valveteam/documentation/README.md

# documentation
Contains documentation files for valve team (GM2)
