valveteam/documentation/enclosure files/light_enclosure.stl

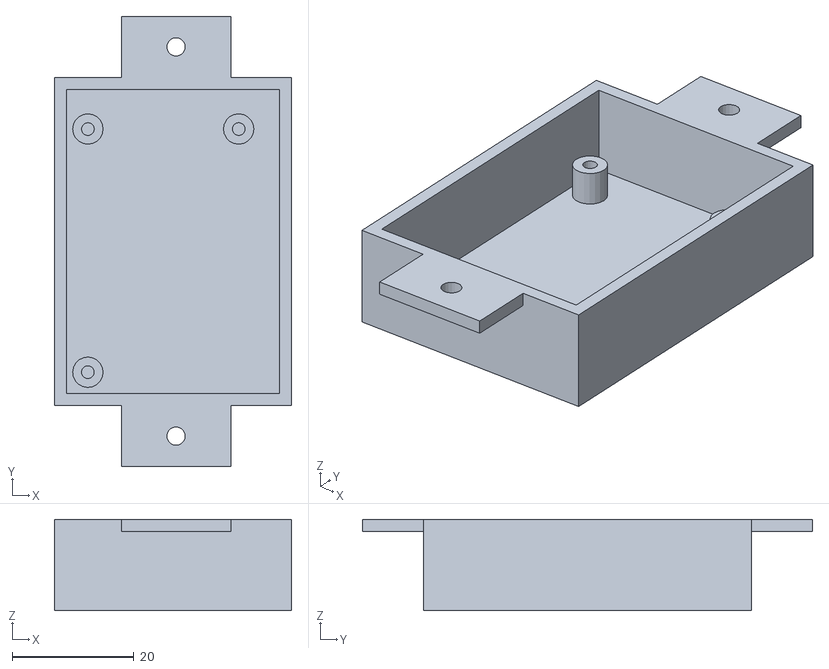
[picture p21: CAD file, 2018-06-06]
enclosure files/light_enclosure.stl
39.0 x 74.0 x 15.0
