valveteam/documentation/enclosure files/control_flow_enclosure.stl

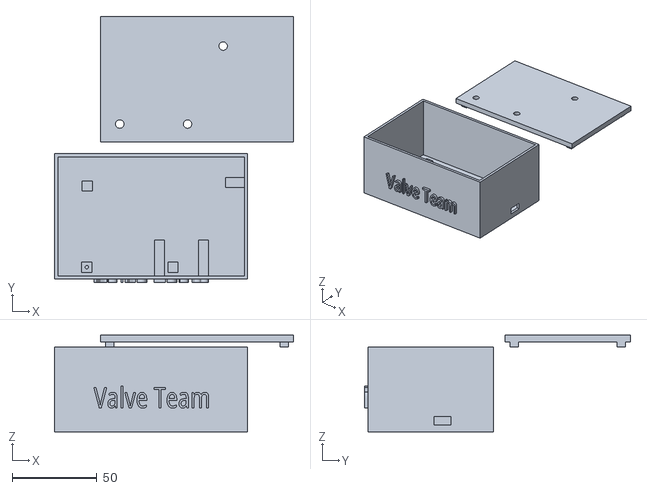
[picture p22: CAD file, 2018-06-06]
enclosure files/control_flow_enclosure.stl
141.0 x 157.0 x 57.0
