valveteam/documentation/submodules/light_module_res/light_module_schematic.pdf

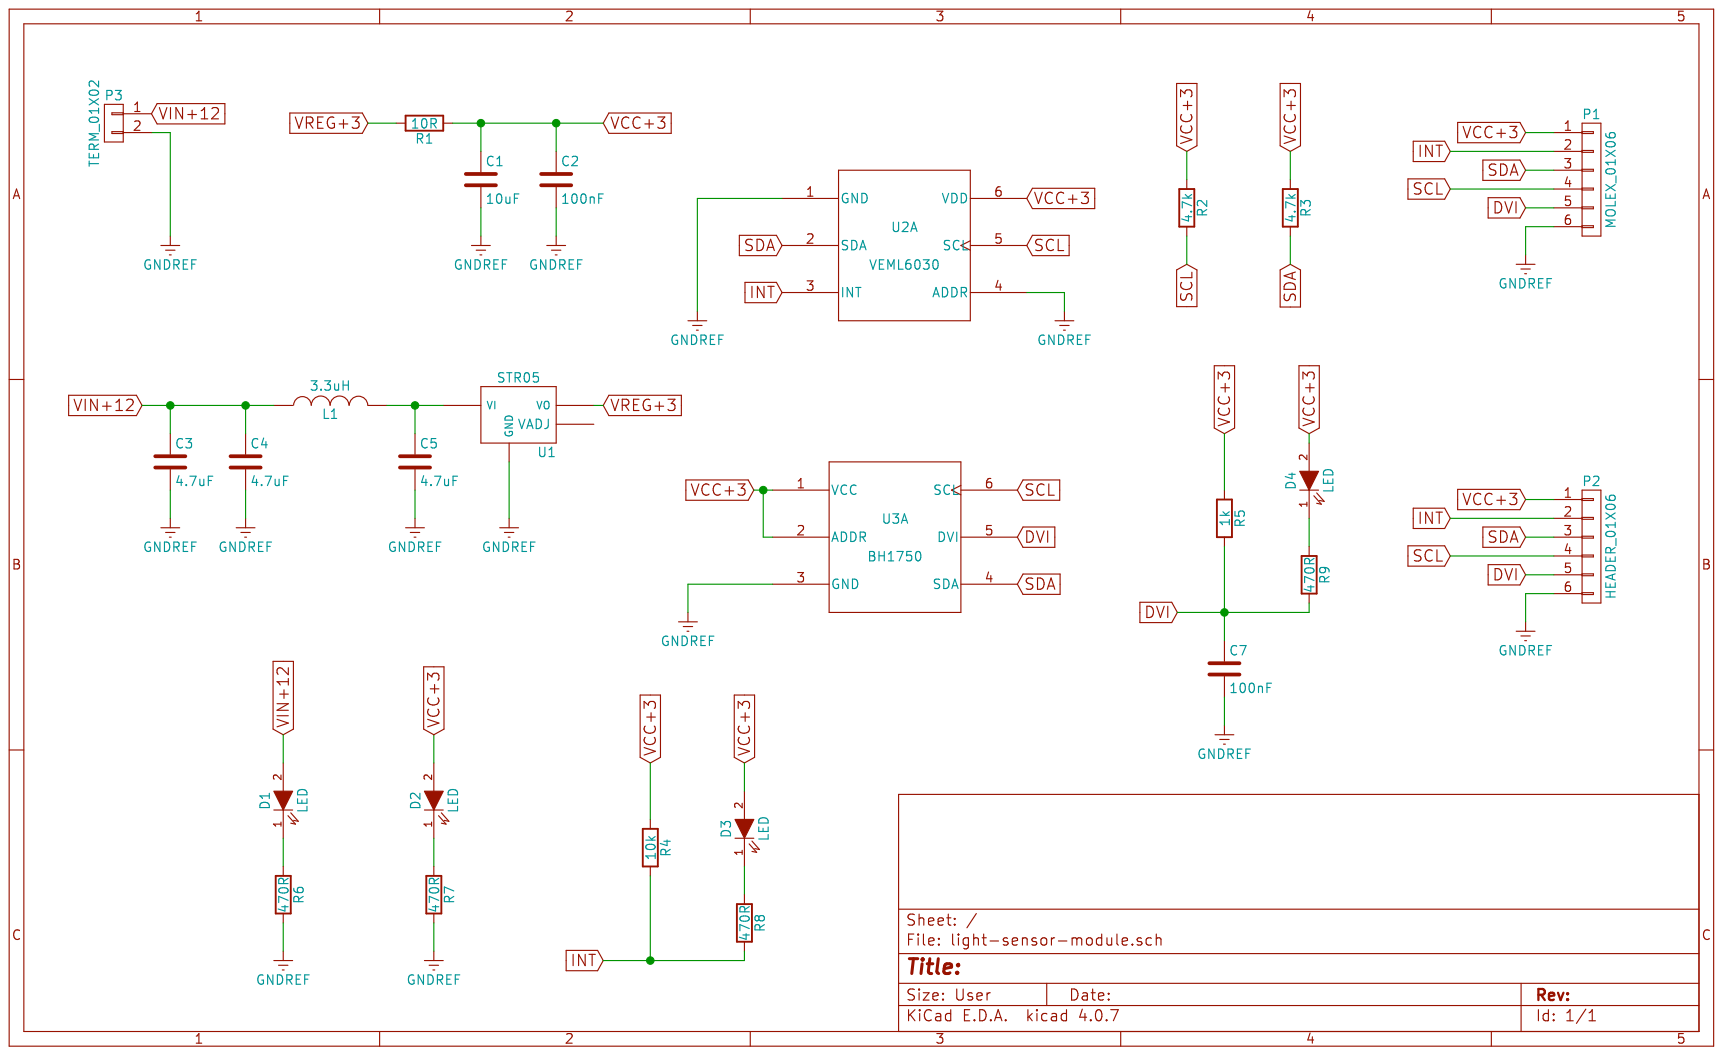
[picture p23: page 1]
