valveteam/documentation/(commit log)

2018-05-31 initial flow_control_module work.
2018-06-04 Add information about valves.
2018-06-05 Add resources for light sensor module
2018-06-05 Add additional resources to light sensor module
2018-06-06 Initial draft of light sensor module documentation
2018-06-06 enclosures and documentation
    [control_flow_enclosure.stl, light_enclosure.stl]
2018-06-06 Finalise valve docs.
2018-06-06 Add teamwork md file (currently a clone)
2018-06-07 Update light module schematic so clearer
2018-06-07 Complete light sensor module documentation
2018-06-07 flow chart control
2018-06-07 added flow chart
2018-06-07 pics for enclosures
2018-06-07 Add enclosures documentation
2018-06-07 Update system enclosures documentation
2018-06-07 Add link to GitHub for enclosures
